abdulazizumarovich/3d-espresso-splitter/README.md

# 3D Espresso Splitter

A 3D-printable splitter for the Wacaco Picopresso, or any naked portafilter. It sits on two cups and is designed to divide one shot evenly between them, **wherever the coffee lands in the funnel**. It has no ball, no insert and no moving parts.

> **Status: prototype.** It hasn't been printed or water-tested yet. Every accuracy figure below is a calculation. If you print it, please share your water-test results.

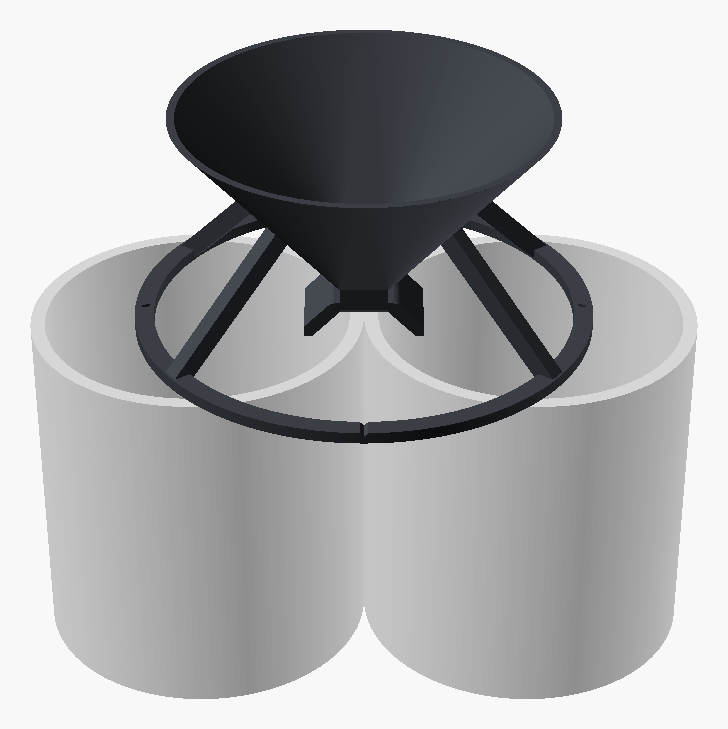
[picture p1: images/assembly.png]
Splitter on two cups


## How it works

1. A flat **ring** rests on the rims of two cups standing side by side. Four struts hold a 76 mm **funnel** above them.
2. Coffee poured anywhere into the funnel runs down to the bottom. Under the funnel sits the **keel**, a small block holding a short channel, the **culvert**. Two **1.6 mm bores** lead out of the culvert, one toward each cup. They are narrow, so the coffee backs up into a **small pool** (about 1–3 ml during the shot).
3. The two bores sit **back to back on one horizontal line**, at the same height, along the **cup axis** (the line through both cup centres). Their inlets are 4 mm apart. The pool surface is level, so both bores have the same depth of coffee above them and pass the same flow, wherever the coffee came from.
4. A small **lid** covers the culvert, so a falling stream can't hit the bores directly.
   - The pool reaches the culvert only through **two inlet slots, one at each end**.
   - Both slots sit on the centre line between the cups and face sideways under a 45° hood.
   - No straight-down stream can reach the culvert. Only small corners at the slot entrances can be seen from above.
5. Each bore empties onto its **own chute**, which ends in a drip edge over its cup. Each chute stands on the print bed on a small **foot**. After the split, coffee from one side never touches a surface that the other side's coffee touches.

| Cut through the bores (cups left and right) | Cut through the culvert (bore in the middle) |
|---|---|
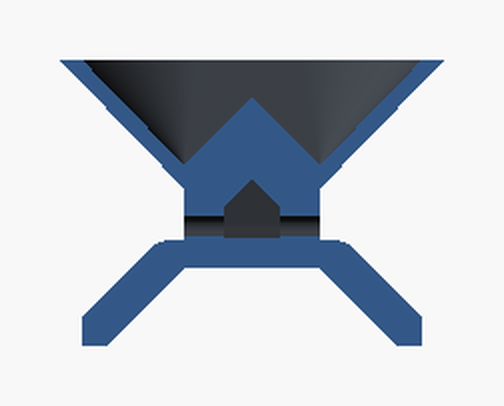
[picture p2: images/keel_closeup.png]
Section through the bores
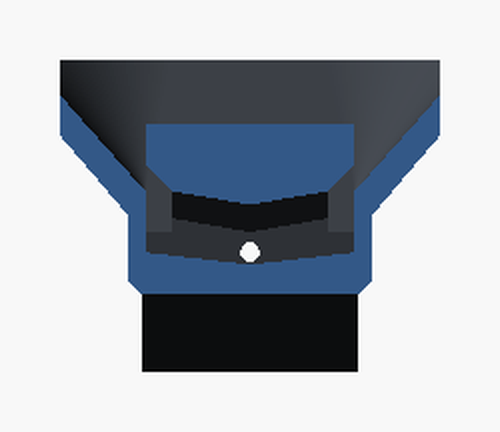
[picture p3: images/culvert_closeup.png]
Section through the culvert
|  |  |

| Top | Bottom |
|---|---|
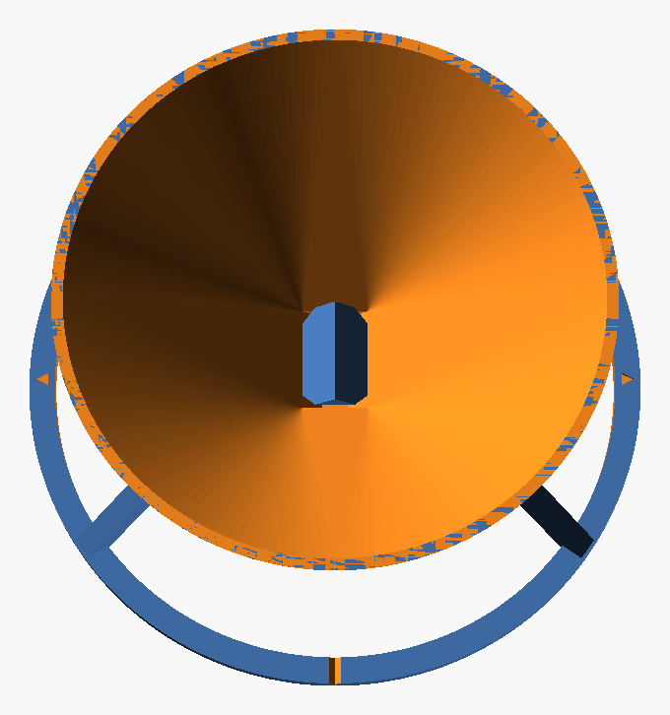
[picture p4: images/top.png]
Top
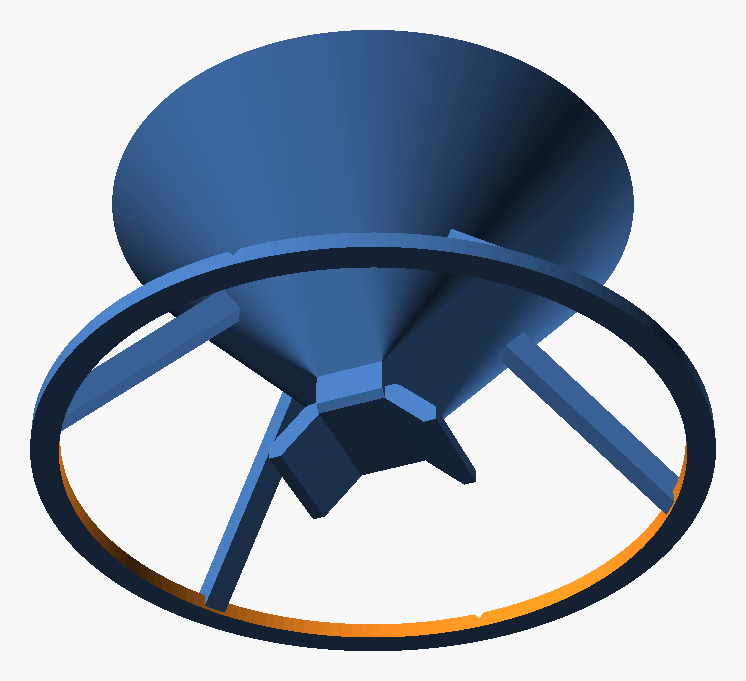
[picture p5: images/bottom.png]
Bottom
|  |  |

### How even is it?

All numbers here are **estimates from flow calculations, not measurements**. Please test your print (see [Water test](#water-test)).

- **Level cups, pre-wetted:** about 50.7/49.3 is typical.
- **Pour position:** no straight-down stream can reach the culvert, and the inlets are mirror images. The estimated effect is under ±0.3 points.
- **Cup height:** if one cup is 1 mm taller, the splitter tilts about 0.7–1.1°. That shifts the split by 0.3 points or less at normal flow (1.2 ml/s and up), and by 1–2 points on a very slow shot (0.5 ml/s).
- **Front-to-back tilt:** no first-order effect, because both bores are at the same height on one line.
- **Hole size:** this matters most. Both bores must come out the **same size with the same edges**, so follow the drilling steps exactly. A 0.01 mm size difference is worth about 0.3 points.

For comparison, ordinary double spouts can be several grams apart between cups (Barista Hustle).

## Specs

| | |
|---|---|
| Parts | 1, printed upright, no supports |
| Weight | about 21 g in PETG |
| Size | 96 mm ring, 47.5 mm tall above the cup rims |
| Funnel | 76 mm mouth, holds 64 ml up to the rim |
| Cups | two cups of the same height, rim diameter about 55–85 mm, touching or a few mm apart |

## Printing

| Setting | Value |
|---|---|
| File | `stl/splitter.stl`, already oriented |
| Material | **PETG** or PCTG. Not PLA: it softens around 60 °C, and fresh espresso is hotter. |
| Layer height | 0.2 mm (0.16 mm gives a smoother funnel) |
| Walls | 3 |
| Supports | None. The only overhang is one 10 mm flat bridge under the keel, so keep bridging on. |
| Seam | Aligned or rear (the +Y side), away from the bores |
| Travel | Turn on "avoid crossing perimeters" (or combing) so no strings are left inside the culvert |

**Bed grip:** until the struts join the funnel at about 24 mm, the centre of the part stands only on the two small chute feet.
- Add 4 small mouse-ear brim pads (about 3 mm radius), one on each side face of each foot, centred near the foot's inner corner.
- Trim any brim flash off the drip edges afterwards. The drip edges are the outer ends of the chutes.
- Print up to about 25 mm a little slower.

## Drilling the bores (required)

The bores are printed as 1.4 mm pilot holes and drilled out to 1.6 mm by hand.

**Tools:** one **1.6 mm HSS drill bit** (DIN 338) in a **pin vise no wider than 12 mm**. Let the bit stick out at least 12 mm, and put a tape flag on it **4.5 mm from the tip**.

1. **Bore A:** hold the splitter in your hand. Put the bit into the pilot on one outer face of the keel, just above a chute. Keep the vise level: it passes only 0.4 mm above the ring. Turn it in straight along the cup axis until the flag touches the face.
   - That depth takes the full drill diameter through the whole bore and about 1 mm into the culvert.
   - Never go deeper than 6.5 mm, or you would touch the other bore.
2. **Bore B:** repeat from the opposite outer face with the same bit and the same depth.

Drilling each bore from its own side, to the same depth, gives both inlets the same edge. A single pass through both would leave a burr on only one inlet, inside the culvert where you can't reach it.

3. **Clean the culvert:** flush hot water through the funnel. Then blow through each slot, or work a thin interdental brush in through a slot, to clear chips and strings.
4. **Deburr:** clean both outer bore edges the same way, for example with one light twist of a countersink each.
5. **Check:** the smooth shank of the bit should slide into each bore as far as the culvert with the same feel. Daylight along the axis alone isn't enough, because the undrilled pilots are see-through too.

## Use

1. **Place:** stand two cups of the same height next to each other on a level surface. Turn the splitter so the **two engraved arrows point along the line through both cup centres** and the **two notches sit over the line where the cups touch**.
2. **Pre-wet:** rinse it with hot water and give it one shake. Both bores then start wet, which matters for the first drops.
3. **Brew:** hold the Picopresso anywhere over the funnel, clear of the rim, and pull the shot.
4. **Wait:** let the funnel empty before you lift it. During fast pumping the funnel fills partly as a buffer, so the cups keep filling for about 5–15 s after the shot.

## Cleaning

- Rinse hot water through the funnel. It runs through the culvert and both bores.
- The culvert is a short roofed channel, 4 mm wide and about 11 mm long, reached through the two hooded slots. Hot water flushes it on every rinse. Once a week, blow through each slot or work a thin interdental brush (size 0–1) in through a slot. If you want easier brush access, print with `hood_lift = 1` (see Customising).
- Clean both bores with a fine interdental brush or pipe cleaner, the **same number of passes each side**. Oil films change how coffee wets the plastic, and the split relies on both sides behaving alike.
- Hand wash only. Dishwasher heat can warp PETG.

## Water test

Do this once after printing.

1. Use two identical cups on a level table, and a scale that reads to 0.1 g.
2. Pour 40 ml of hot water (80–85 °C):
   - slowly (about 0.5 ml/s), medium (1–1.5 ml/s) and fast (about 3 ml/s; the funnel will visibly fill);
   - also through the Picopresso with an empty basket.
3. Repeat at different pour positions: centre, near each cup, front, back, and a deliberately wandering pour.
4. **Turn the splitter 180°** and repeat.
   - If the extra flow follows the splitter, the cause is the bores. Re-check the drilling and deburring. As a last resort, give the outer edge of the bore on the side that gets *less* one more light countersink twist.
   - If it stays on one side of the table, the cups or the table aren't level.
5. Optionally, put a 1 mm shim under one cup. At medium and fast pours, expect a shift of 0.5 points or less. At about 0.5 ml/s, expect 1–2 points.

**Target:** each cup within 49–51 % of the total.

## Customising

Open `src/shot_splitter.scad` in [OpenSCAD](https://openscad.org) and use the Customizer.

| Parameter | Default | Effect |
|---|---|---|
| `mouth_d` | 76 | Funnel mouth. Smaller is lighter (68 gives about 19 g, 46 ml and 43 mm height), with less room to aim. |
| `bore_d`, `pilot_d` | 1.6, 1.4 | Final and printed bore sizes. Larger bores drain faster but build a shallower pool, which is less tolerant of tilt. |
| `ring_r` | 46 | Ring radius. Larger gives a steadier stance on big cups. |
| `strut_angle` | 35 | Strut angle from the cup axis. Keep it away from 45 so the part only looks right one way round. |
| `hood_lift` | 0 | Raise the slot hoods, for example to 1, to widen the opening for brushing the culvert. A bit more of the slot corners then shows from above. The culvert itself stays hidden. |

Export the STL. Pass the same `-D` values you changed in the Customizer, because the command line uses the file's defaults:

```sh
openscad -D mouth_d=76 -o stl/splitter.stl src/shot_splitter.scad
```

To see it on two cups, open the file in OpenSCAD, set `part = "preview"` and press F5. Or render an image:

```sh
xvfb-run -a openscad -D 'part="preview"' --viewall --autocenter -o preview.png src/shot_splitter.scad
```

The check script needs `pip install trimesh networkx shapely mapbox-earcut manifold3d rtree`. It checks:
- one watertight solid and its weight
- bridges and overhangs
- mirror symmetry
- drill and pin-vise access
- line of sight from above
- pool volume

Run `python3 tools/check_mesh.py` for the default build. For a customised build, pass the same values, for example `python3 tools/check_mesh.py mouth_d=68 hood_lift=1`.

## Background

- **v1** dropped the stream onto a knife-edge ridge. At espresso flow rates coffee runs as a film down one side of the funnel, so the split followed the pour.
- **v2** used a level trough with two holes 28 mm apart. It was far more sensitive to tilt.
- **v3** keeps the pool idea. It brings the bores together on one axis, shields them from the stream, and matches their size by drilling.

The 35 mm steel ball in the Meticulous splitter is for extract chilling (the Hugh Kelly technique), not for splitting. A ball also passes the pour position straight through. So this design leaves it out.

More notes and the research behind the design are in [CONTEXT.md](CONTEXT.md).
