abdulazizumarovich/3d-espresso-splitter/stl/splitter.stl

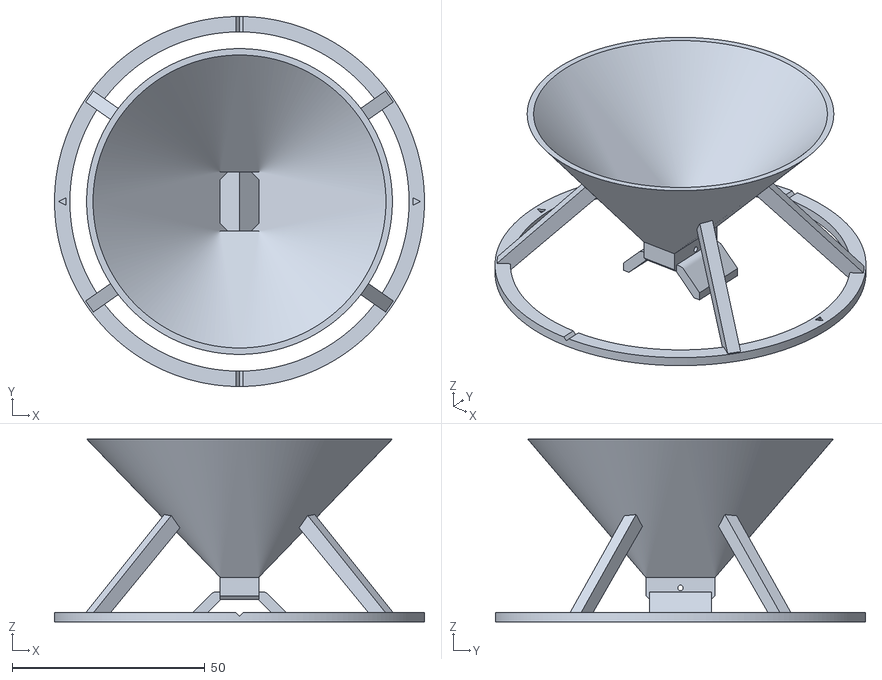
[picture p6: CAD file, 2026-10-15]
stl/splitter.stl
96.0 x 96.0 x 47.5
