abdulazizumarovich/3d-espresso-splitter/(commit log)

2026-10-15 Add Picopresso two-cup shot splitter model
    Parametric OpenSCAD source, print-ready STLs for the base and funnel,
    preview renders and a README with print settings.
    Claude-Session: https://claude.ai/code/session_01ECSvz5pPPrQWSbo9Yf1bD2
    [base.stl, funnel.stl, shot_splitter.scad]
2026-10-15 Redesign as a one-piece open-top pool splitter
    Replace the ring holder and separate funnel with a single open basin on
    four legs. Coffee runs into a level trough with two identical outlet
    holes, so a small pool forms and both cups get the same flow wherever
    the coffee lands. No enclosed chamber, smooth interior, no supports
    needed, and about 27 g instead of 71 g.
    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
    [base.stl, funnel.stl, shot_splitter.scad, splitter.stl]
2026-10-15 Add ball-free v3 "culvert" splitter (work in progress)
    Replace the v2 trough with a level-pool design: a 76 mm funnel on a ring
    holder drains into a short roofed culvert whose two inlets lie on the
    mirror plane between the cups. Two horizontal 1.6 mm bores on one axis,
    reamed together in one pass, meter the pool onto open chutes and drip
    lips over each cup. The part is mirror-symmetric, about 21 g and prints
    without supports. README still describes v2; it is updated after review.
    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
    [shot_splitter.scad, splitter.stl]
2026-10-15 Apply review fixes to v3 and document it
    Hood the inlet slots so no straight-down stream reaches the culvert,
    slope the culvert floor toward the bores and raise its ceiling toward
    the slots for venting, ream each bore from its own side (1.4 mm pilot),
    widen the chutes and feet for bed grip, use a square drip edge, thicken
    the keel floor, align heights to 0.2 mm layers, set the struts at 35
    degrees so the part only looks right one way round, and shrink the
    engraved arrows. Rewrite README and CONTEXT for v3 and extend the
    mesh checks (line of sight, drill access, pool volume).
    Claude-Session: https://claude.ai/code/session_01ECSvz5pPPrQW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
    [shot_splitter.scad, splitter.stl]
2026-10-15 Fix drilling depth and docs after final check
    Drill each bore to a 4.5 mm depth flag so the full diameter reaches the
    inlet, add a prototype status note, clarify bore layout, alignment, bed
    grip, cleaning, drain time and shim-test expectations, and add an
    optional hood_lift setting for easier culvert brushing. The check
    script now accepts -D style overrides for customised builds.
    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
    [shot_splitter.scad, splitter.stl]
